arjunrajasekaran201/Chloro-Gauge/CAD DESIGNS/ELECTRONICS/texture613057584_826298173_16777215.png

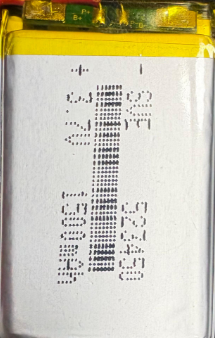
CAD DESIGNS/ELECTRONICS/texture613057584_826298173_16777215.png
