arjunrajasekaran201/Chloro-Gauge/IMAGES/20251020_181038912_iOS.jpg

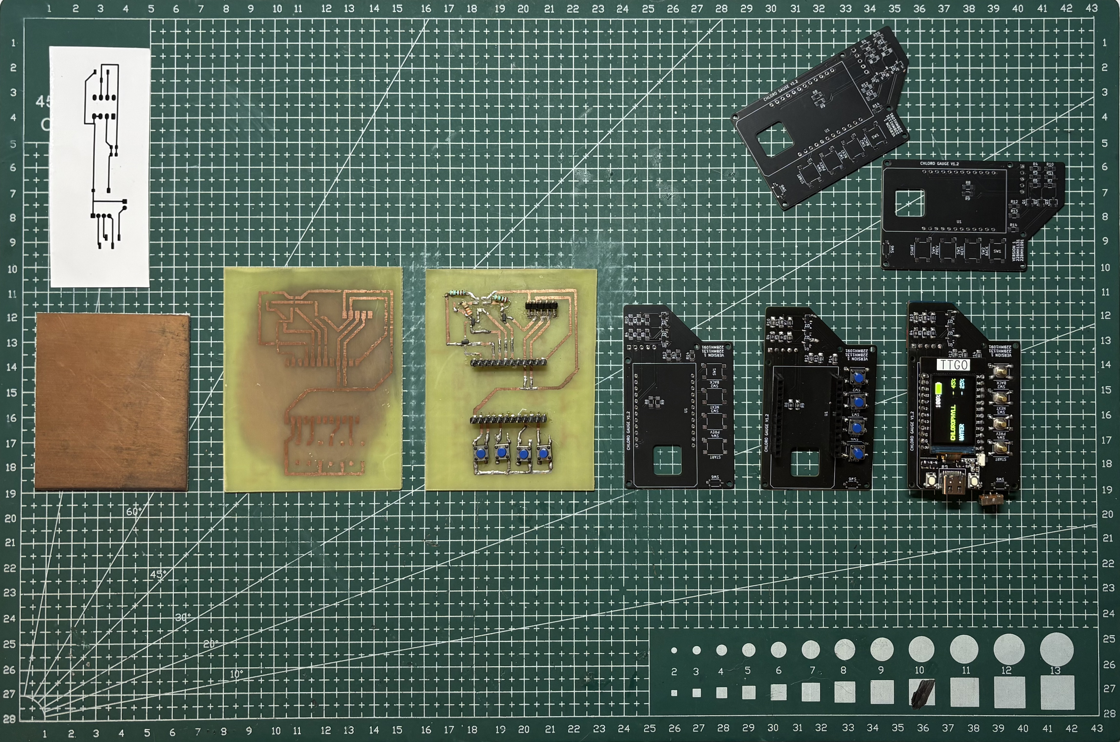
IMAGES/20251020_181038912_iOS.jpg
