arjunrajasekaran201/Chloro-Gauge/REFERENCE/Links.txt

EPS32 Sparkfun - https://docs.sparkfun.com/SparkFun_Thing_Plus_ESP32_C6/print_view/?utm_source=chatgpt.com
