arjunrajasekaran201/Chloro-Gauge/IMAGES/20251020_180931866_iOS.jpg

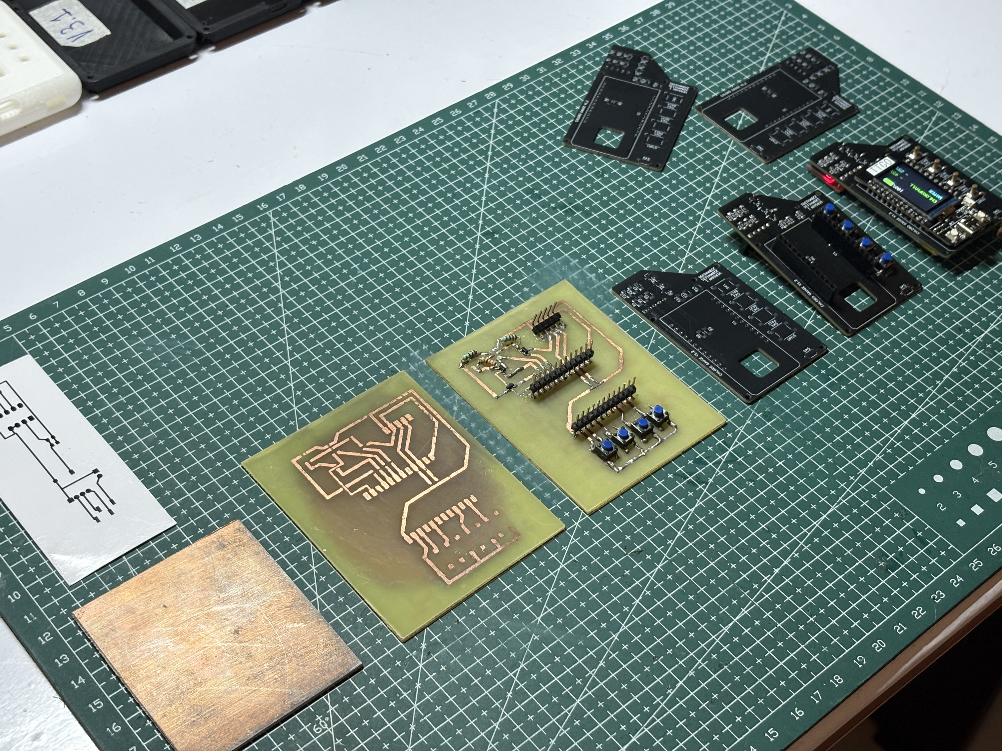
IMAGES/20251020_180931866_iOS.jpg
