arjunrajasekaran201/Chloro-Gauge/IMAGES/20251020_181259716_iOS.jpg

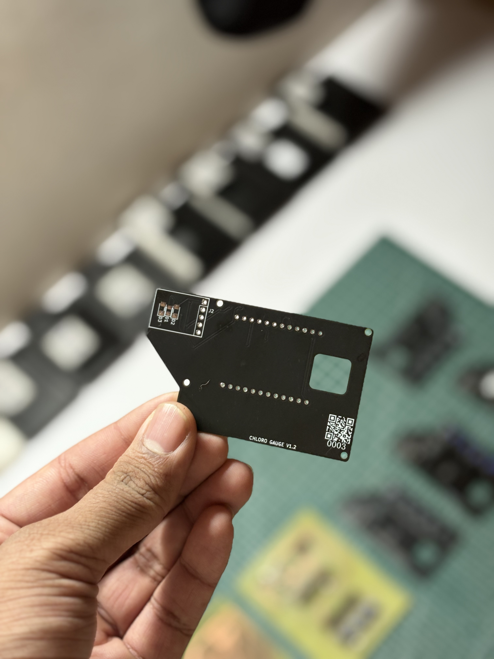
IMAGES/20251020_181259716_iOS.jpg
