arjunrajasekaran201/Chloro-Gauge/IMAGES/20251020_181925314_iOS.jpg

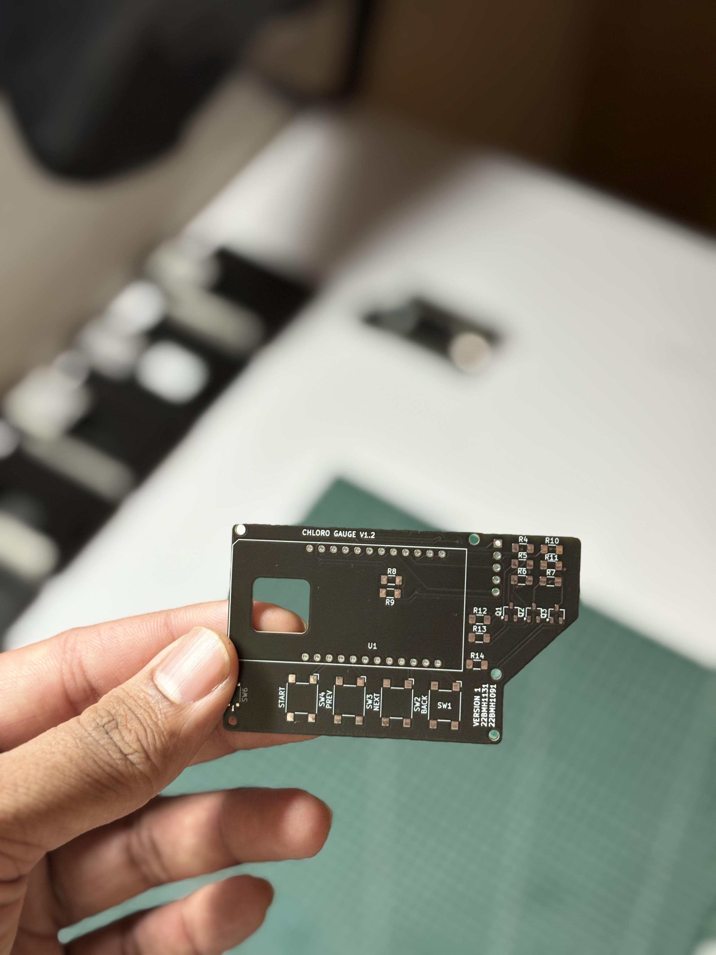
IMAGES/20251020_181925314_iOS.jpg
