arjunrajasekaran201/Chloro-Gauge/IMAGES/20251020_182045030_iOS.jpg

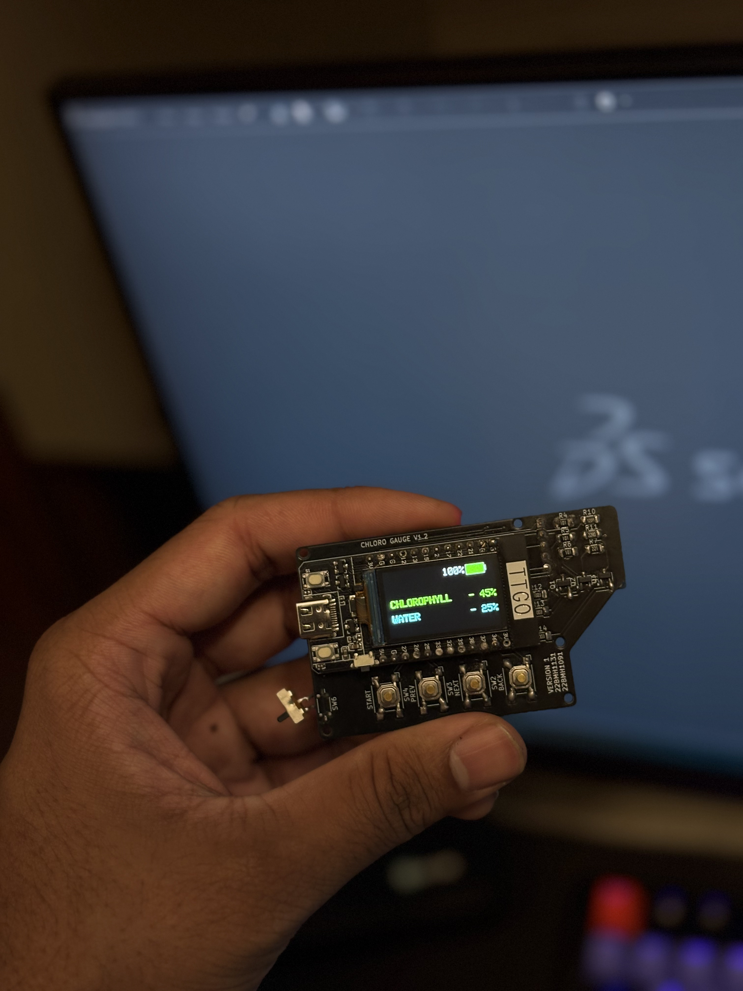
IMAGES/20251020_182045030_iOS.jpg
