arjunrajasekaran201/Chloro-Gauge/IMAGES/20251024_093119306_iOS.jpg

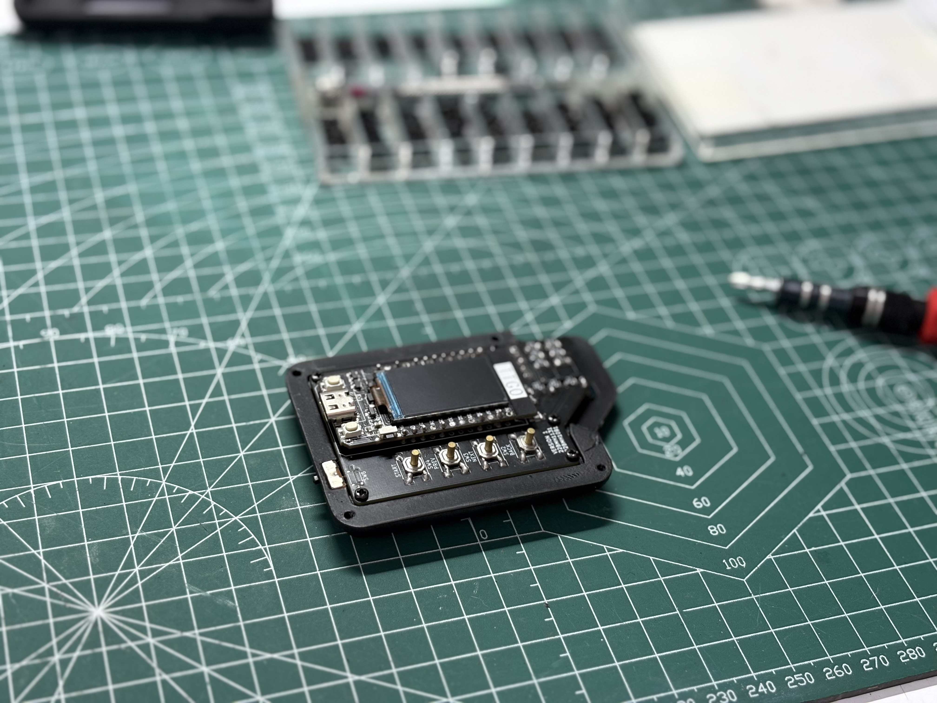
IMAGES/20251024_093119306_iOS.jpg
