arjunrajasekaran201/Chloro-Gauge/IMAGES/20251024_094013495_iOS.jpg

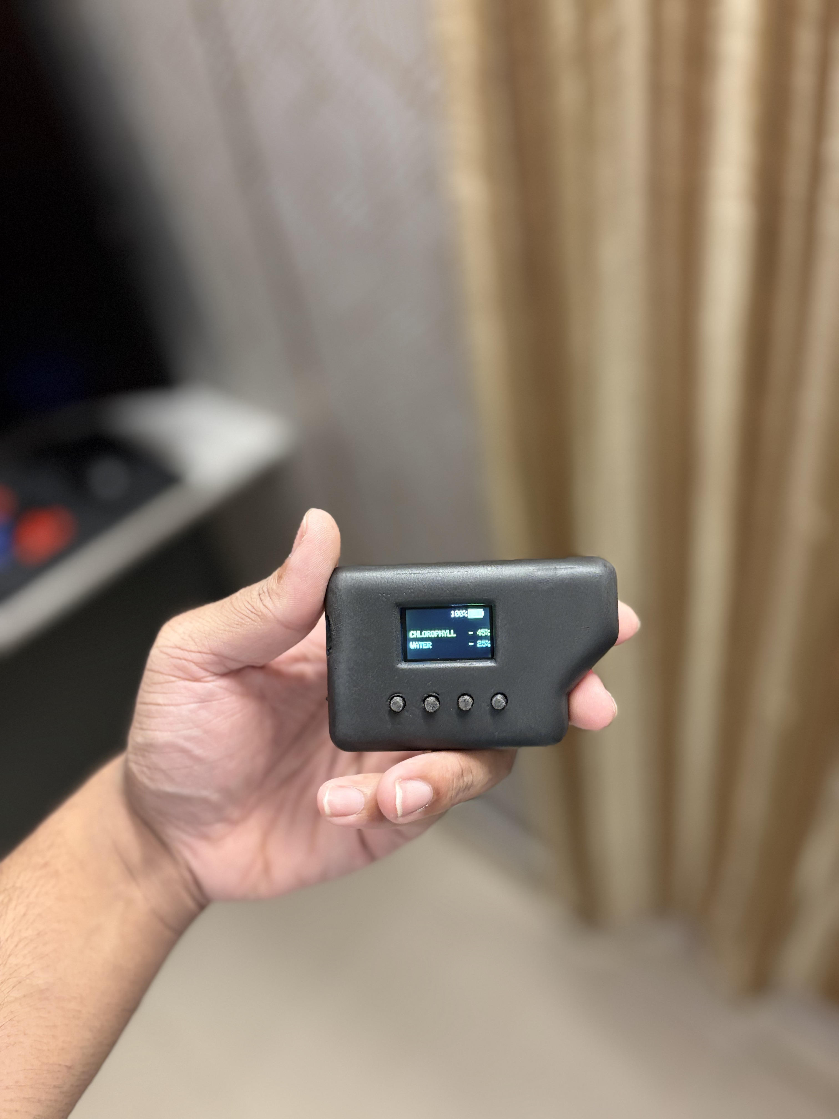
IMAGES/20251024_094013495_iOS.jpg
