arjunrajasekaran201/Chloro-Gauge/IMAGES/20251024_094024455_iOS.jpg

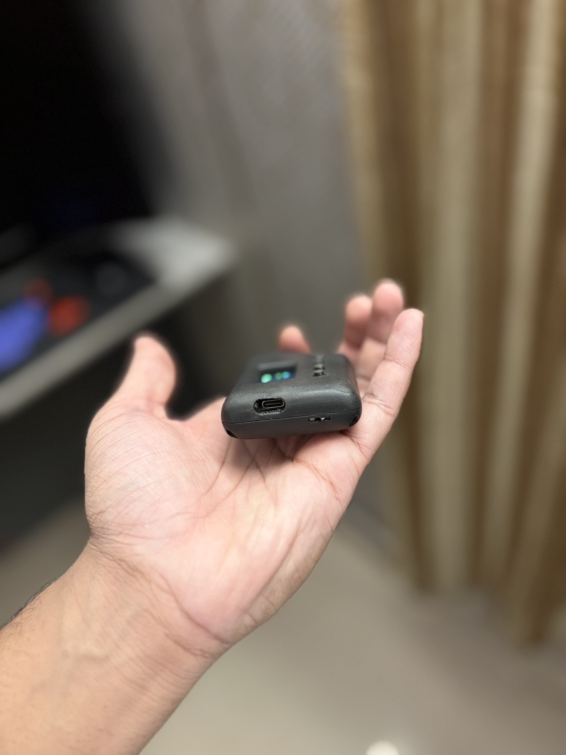
IMAGES/20251024_094024455_iOS.jpg
