arjunrajasekaran201/Chloro-Gauge/IMAGES/20251024_094029636_iOS.jpg

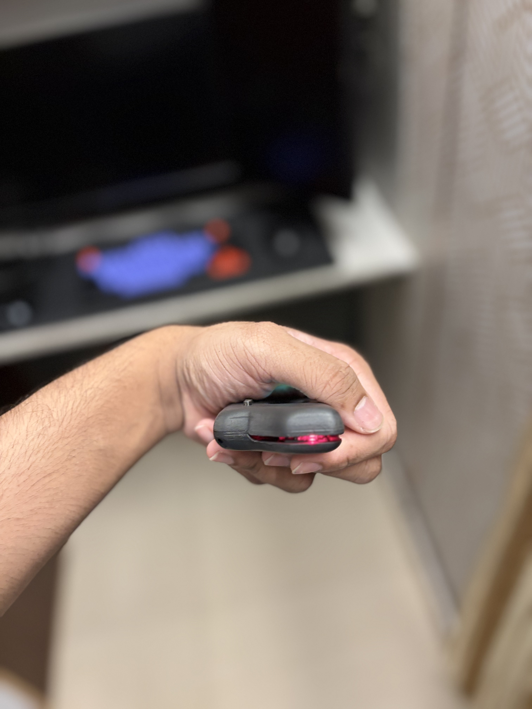
IMAGES/20251024_094029636_iOS.jpg
