arjunrajasekaran201/Chloro-Gauge/IMAGES/20251024_095227139_iOS.jpg

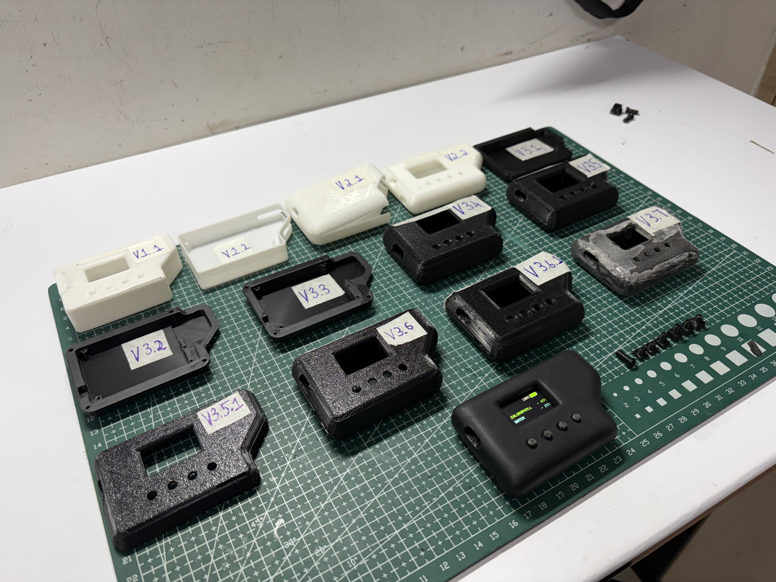
IMAGES/20251024_095227139_iOS.jpg
