arjunrajasekaran201/Chloro-Gauge/IMAGES/20251024_095240331_iOS.jpg

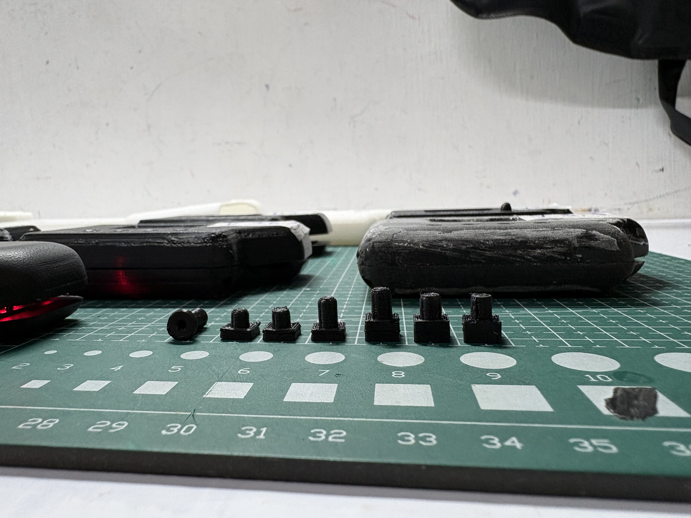
IMAGES/20251024_095240331_iOS.jpg
