arjunrajasekaran201/Chloro-Gauge/IMAGES/20251024_095247498_iOS.jpg

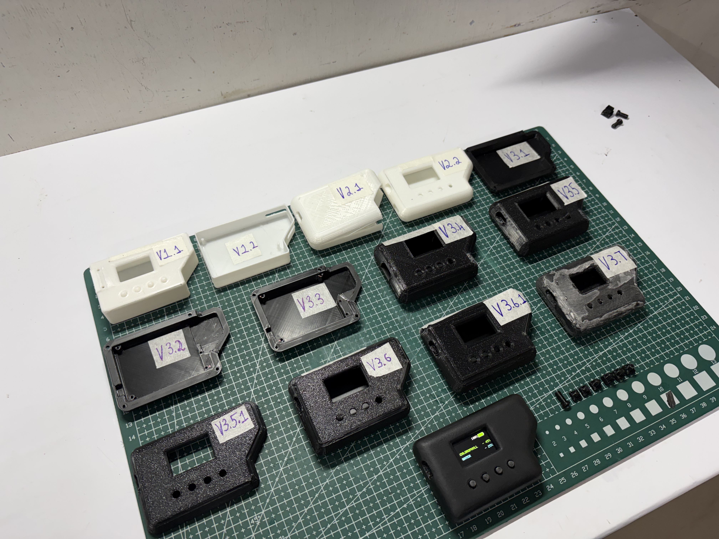
IMAGES/20251024_095247498_iOS.jpg
