arjunrajasekaran201/Chloro-Gauge/IMAGES/20251024_123838072_iOS.jpg

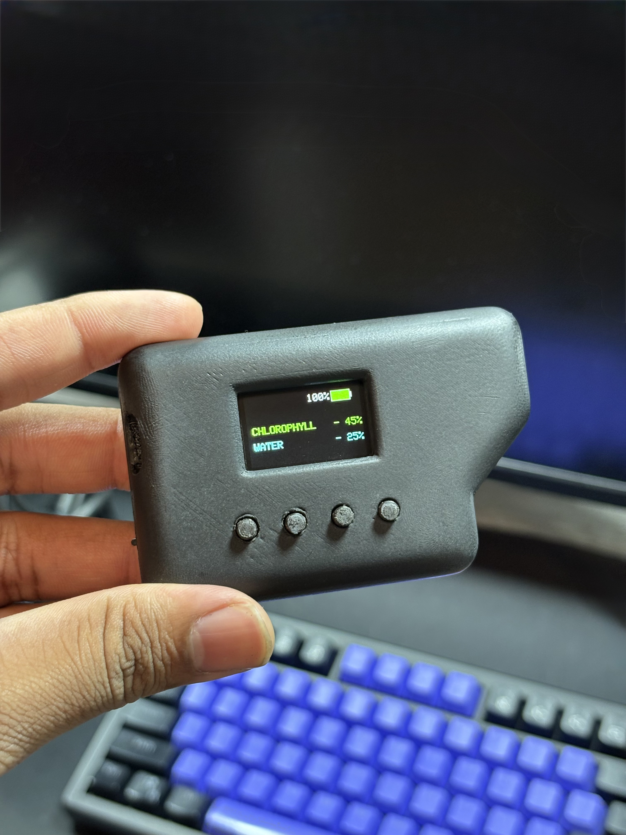
IMAGES/20251024_123838072_iOS.jpg
