arjunrajasekaran201/Chloro-Gauge/IMAGES/file_2025-10-27_20.23.28.png

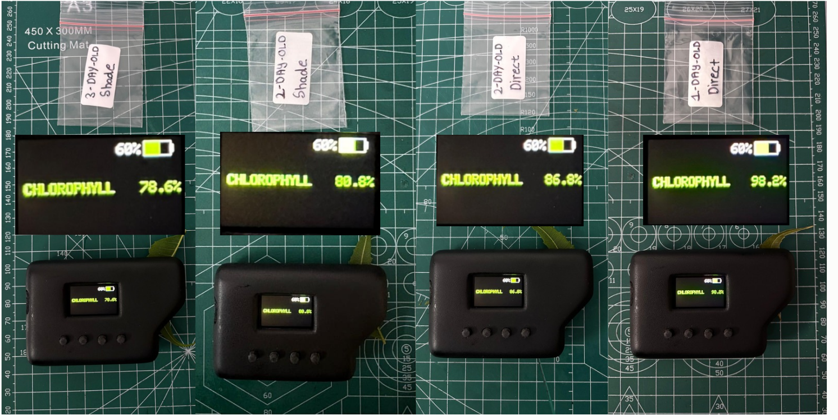
IMAGES/file_2025-10-27_20.23.28.png
