arjunrajasekaran201/Chloro-Gauge/IMAGES/Screenshot 2025-10-21 000112.png

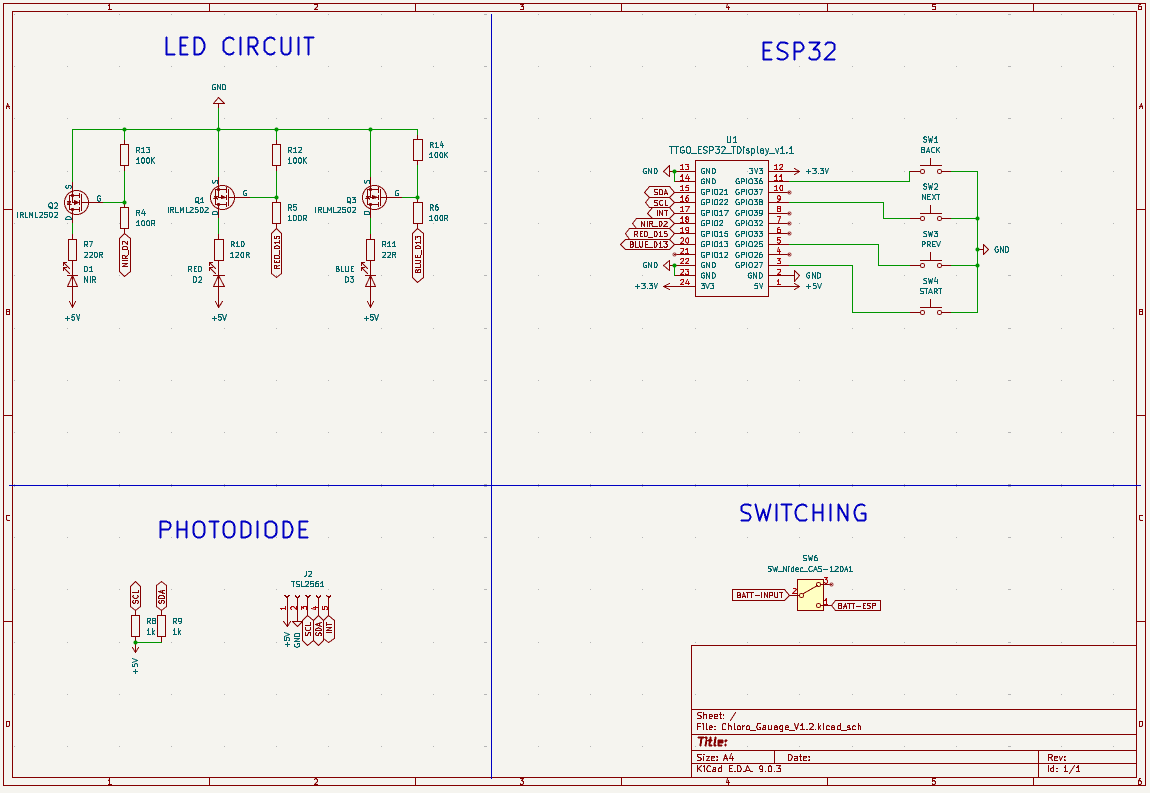
IMAGES/Screenshot 2025-10-21 000112.png
