arjunrajasekaran201/Chloro-Gauge/IMAGES/Screenshot 2025-10-21 000212.png

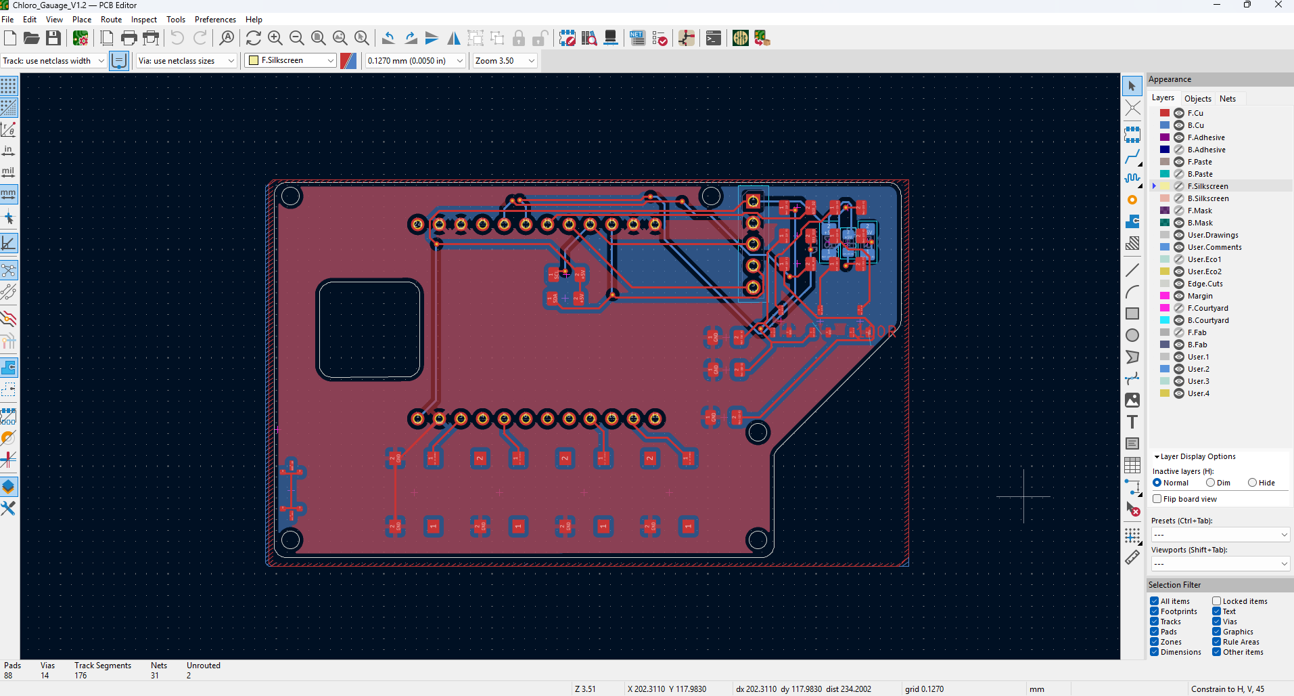
IMAGES/Screenshot 2025-10-21 000212.png
