arjunrajasekaran201/Chloro-Gauge/IMAGES/Screenshot 2025-10-24 180306.png

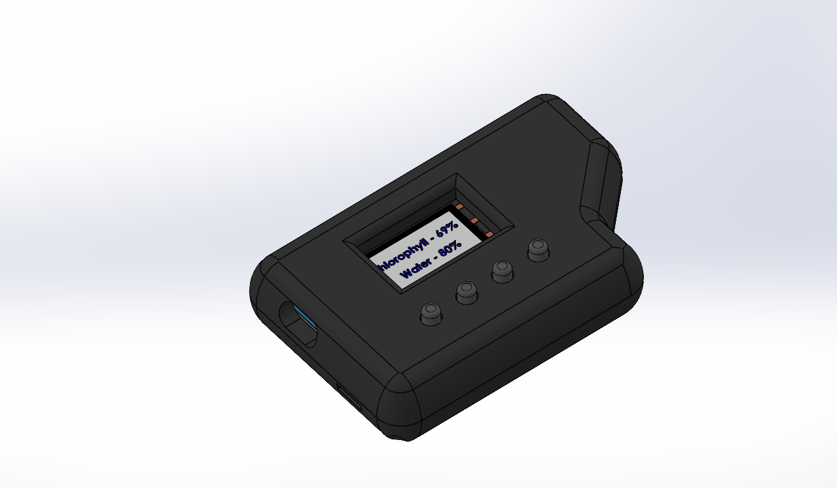
IMAGES/Screenshot 2025-10-24 180306.png
