arjunrajasekaran201/Chloro-Gauge/IMAGES/Screenshot 2025-10-29 220108.png

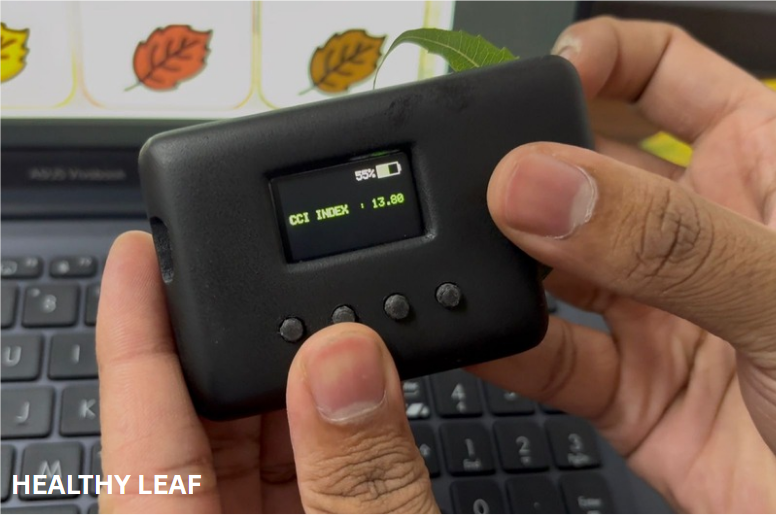
IMAGES/Screenshot 2025-10-29 220108.png
