arjunrajasekaran201/Chloro-Gauge/IMAGES/WhatsApp Image 2025-10-28 at 01.46.50_9ecb65c4.jpg

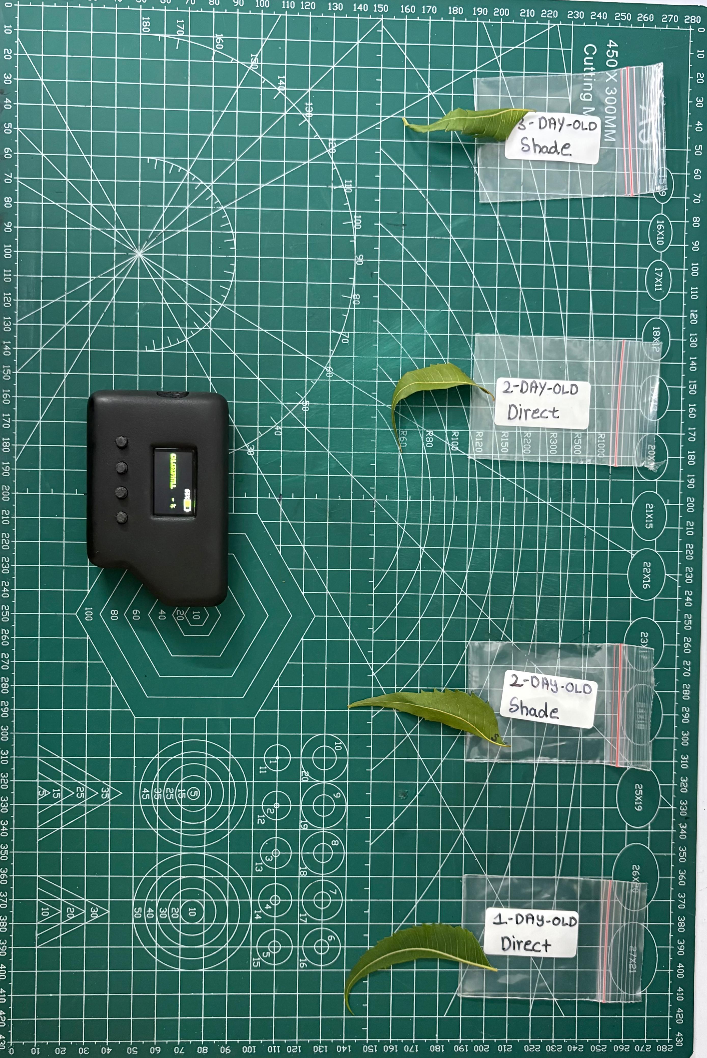
IMAGES/WhatsApp Image 2025-10-28 at 01.46.50_9ecb65c4.jpg
