arjunrajasekaran201/Chloro-Gauge/CAD DESIGNS/KI CAD IMPORTS/TTGO1.SLDASM

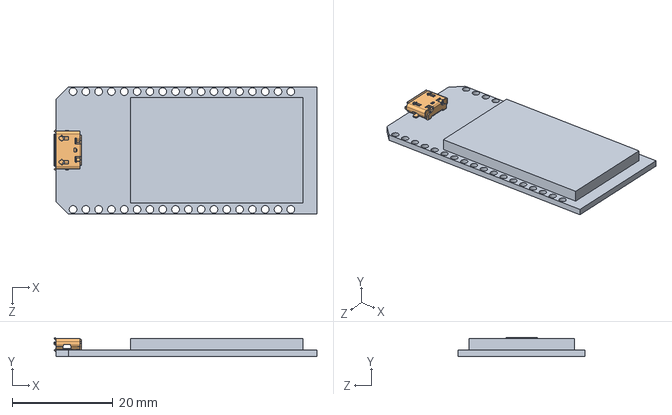
[picture p24: CAD file, 2025-10-29]
CAD DESIGNS/KI CAD IMPORTS/TTGO1.SLDASM
52.1 x 3.77 x 25.1 mm
TTGO-ESP32LORA
microusb
