arjunrajasekaran201/Chloro-Gauge/CAD DESIGNS/CASE DESIGNS/Top Cap V1.SLDPRT

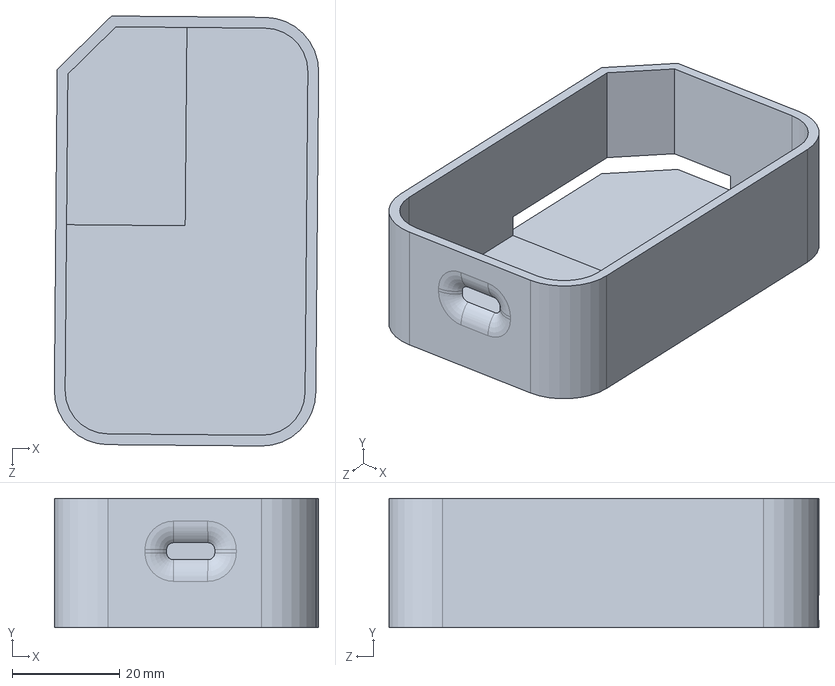
[picture p25: CAD file, 2025-10-29]
CAD DESIGNS/CASE DESIGNS/Top Cap V1.SLDPRT
49.0 x 24.0 x 79.7 mm
