arjunrajasekaran201/Chloro-Gauge/CAD DESIGNS/ELECTRONICS/switch.SLDPRT

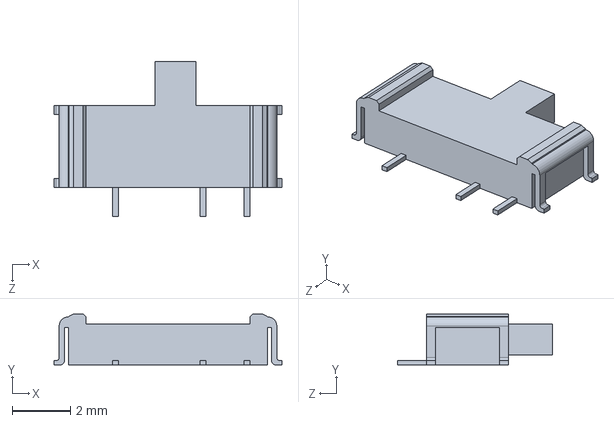
[picture p26: CAD file, 2025-10-29]
CAD DESIGNS/ELECTRONICS/switch.SLDPRT
7.80 x 1.74 x 5.31 mm
