arjunrajasekaran201/Chloro-Gauge/CAD DESIGNS/FINAL DESIGN/Chloro Gauge Top.SLDPRT

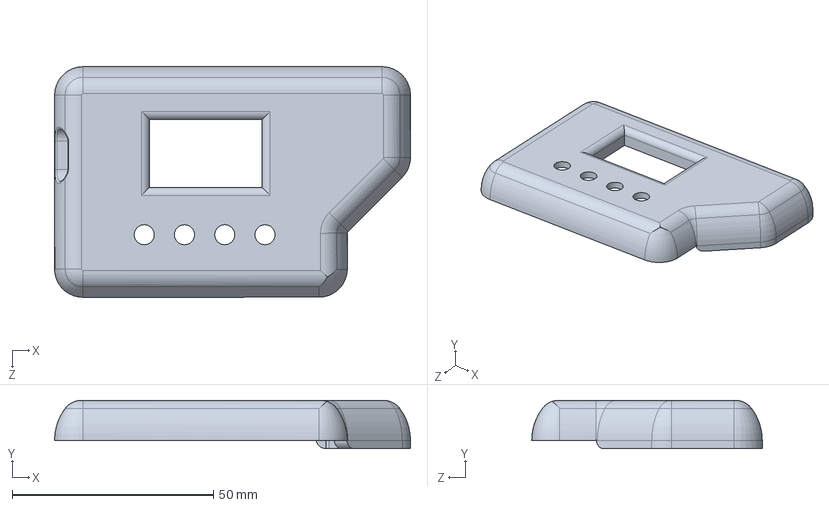
[picture p27: CAD file, 2025-10-29]
CAD DESIGNS/FINAL DESIGN/Chloro Gauge Top.SLDPRT
88.4 x 12.0 x 57.3 mm
