arjunrajasekaran201/Chloro-Gauge/CAD DESIGNS/CASE DESIGNS/Casing_Lower.SLDPRT

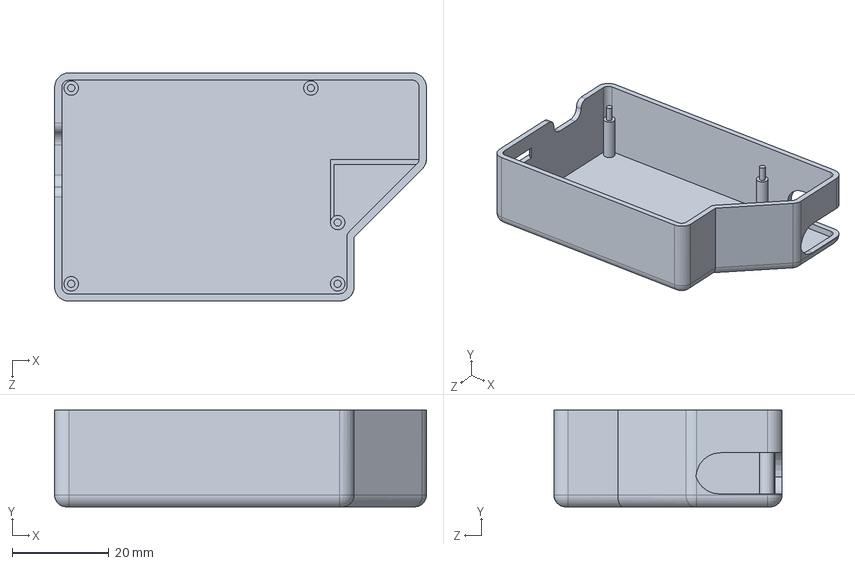
[picture p28: CAD file, 2025-10-29]
CAD DESIGNS/CASE DESIGNS/Casing_Lower.SLDPRT
76.8 x 20.0 x 47.1 mm
