arjunrajasekaran201/Chloro-Gauge/CAD DESIGNS/ELECTRONICS/tsl2561.SLDPRT

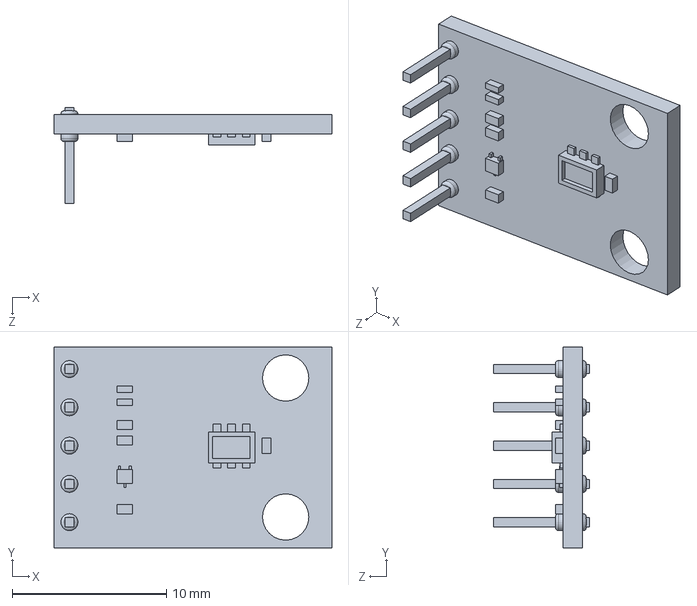
[picture p29: CAD file, 2025-10-29]
CAD DESIGNS/ELECTRONICS/tsl2561.SLDPRT
18.0 x 13.0 x 6.20 mm
