arjunrajasekaran201/Chloro-Gauge/CAD DESIGNS/FINAL DESIGN/Chloro Gauge Bottom.SLDPRT

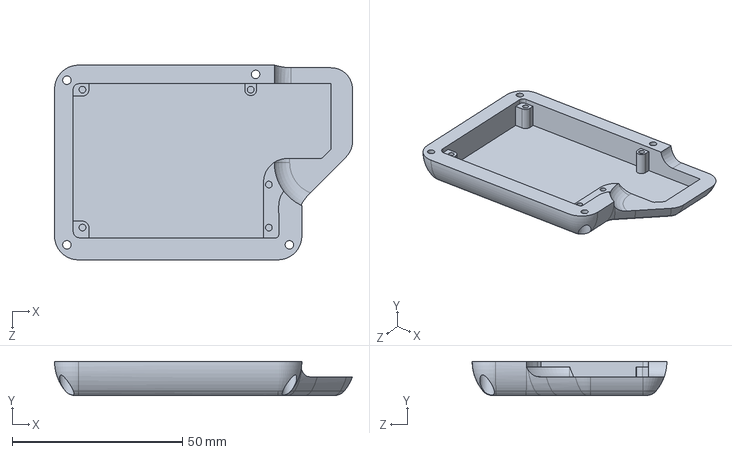
[picture p30: CAD file, 2025-10-29]
CAD DESIGNS/FINAL DESIGN/Chloro Gauge Bottom.SLDPRT
87.6 x 10.0 x 57.3 mm
