arjunrajasekaran201/Chloro-Gauge/CAD DESIGNS/KI CAD IMPORTS/TTGO-ESP32LORA.SLDPRT

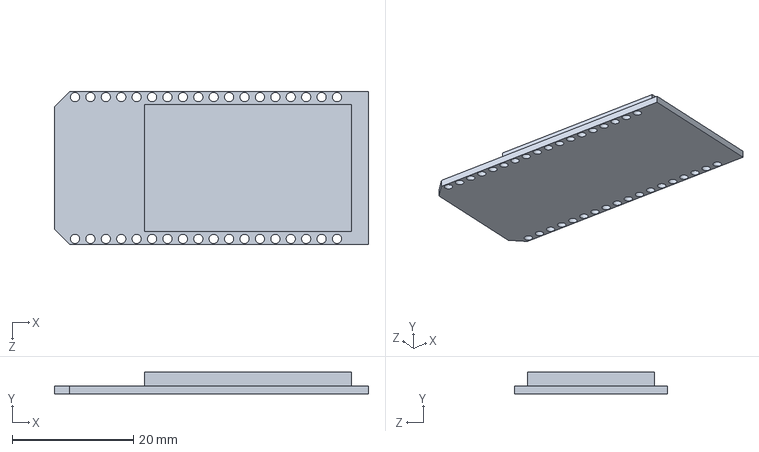
[picture p31: CAD file, 2025-10-29]
CAD DESIGNS/KI CAD IMPORTS/TTGO-ESP32LORA.SLDPRT
51.8 x 3.55 x 25.1 mm
