arjunrajasekaran201/Chloro-Gauge/CAD DESIGNS/CASE DESIGNS/Top lid.SLDPRT

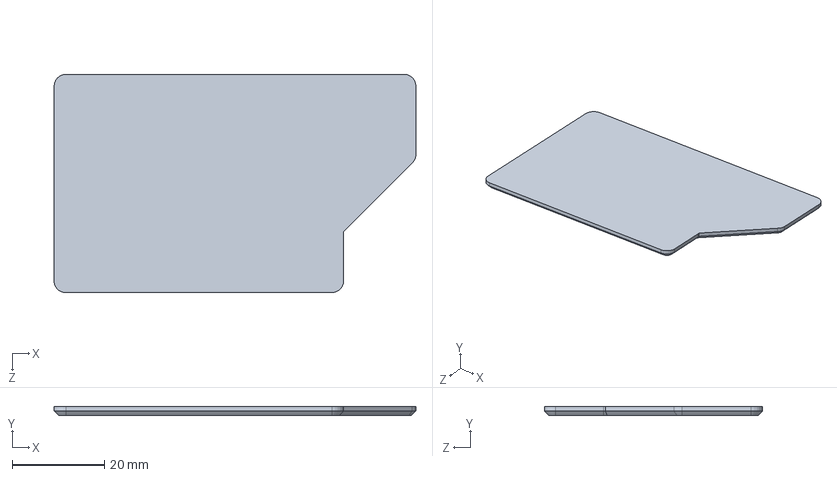
[picture p32: CAD file, 2025-10-29]
CAD DESIGNS/CASE DESIGNS/Top lid.SLDPRT
78.5 x 2.00 x 47.3 mm
