arjunrajasekaran201/Chloro-Gauge/CAD DESIGNS/FINAL DESIGN/button.SLDPRT

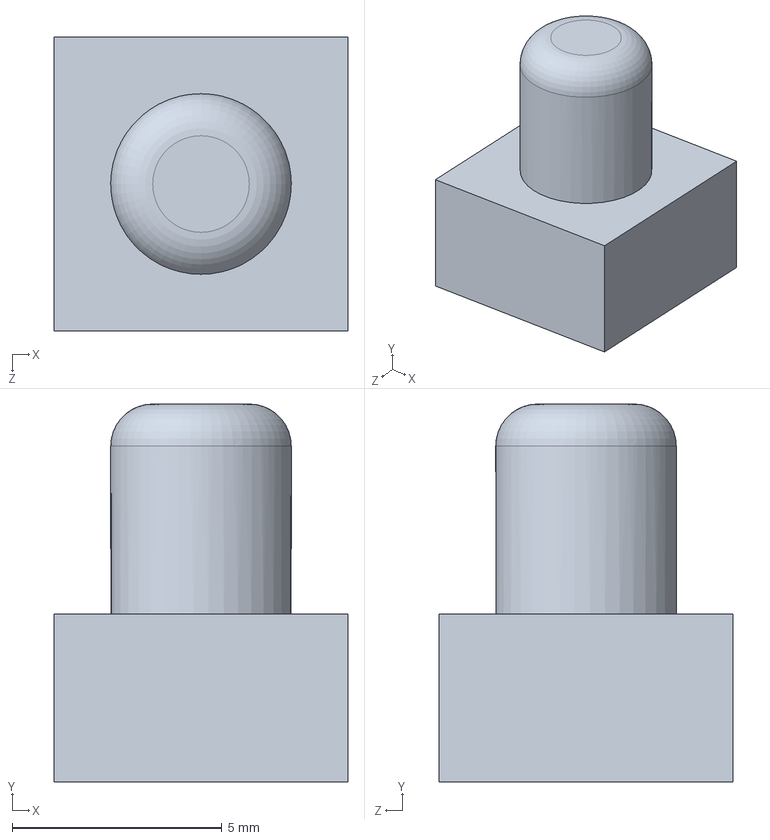
[picture p33: CAD file, 2025-10-29]
CAD DESIGNS/FINAL DESIGN/button.SLDPRT
7.00 x 9.00 x 7.00 mm
