arjunrajasekaran201/Chloro-Gauge/CAD DESIGNS/KI CAD IMPORTS/microusb.SLDPRT

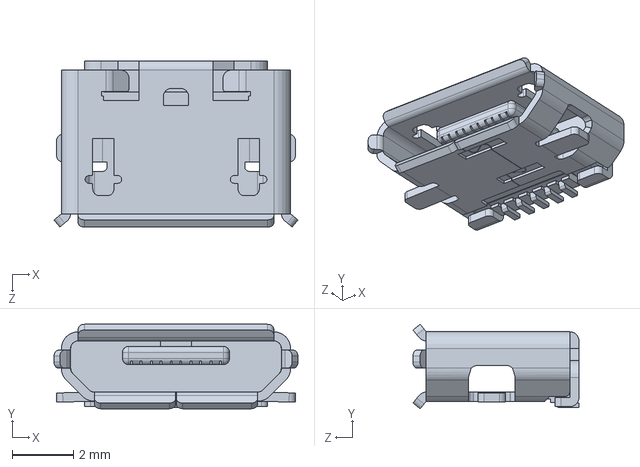
[picture p34: CAD file, 2025-10-29]
CAD DESIGNS/KI CAD IMPORTS/microusb.SLDPRT
7.98 x 2.76 x 5.43 mm
