arjunrajasekaran201/Chloro-Gauge/CAD DESIGNS/CASE DESIGNS/Case lower v2.SLDPRT

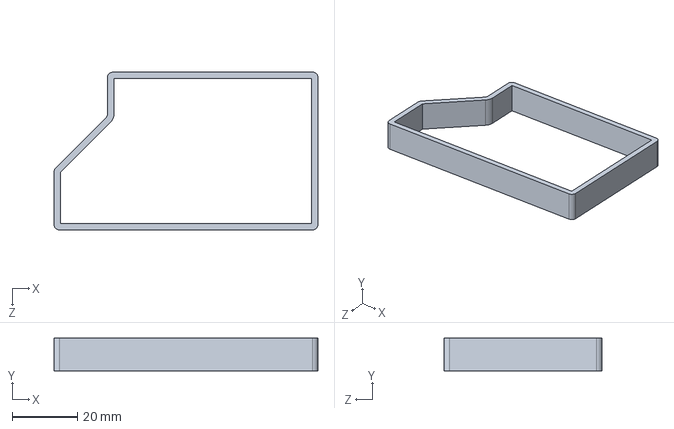
[picture p35: CAD file, 2025-10-29]
CAD DESIGNS/CASE DESIGNS/Case lower v2.SLDPRT
81.2 x 10.0 x 48.5 mm
