arjunrajasekaran201/Chloro-Gauge/CAD DESIGNS/ELECTRONICS/Selector Switch - SS12D00.SLDPRT

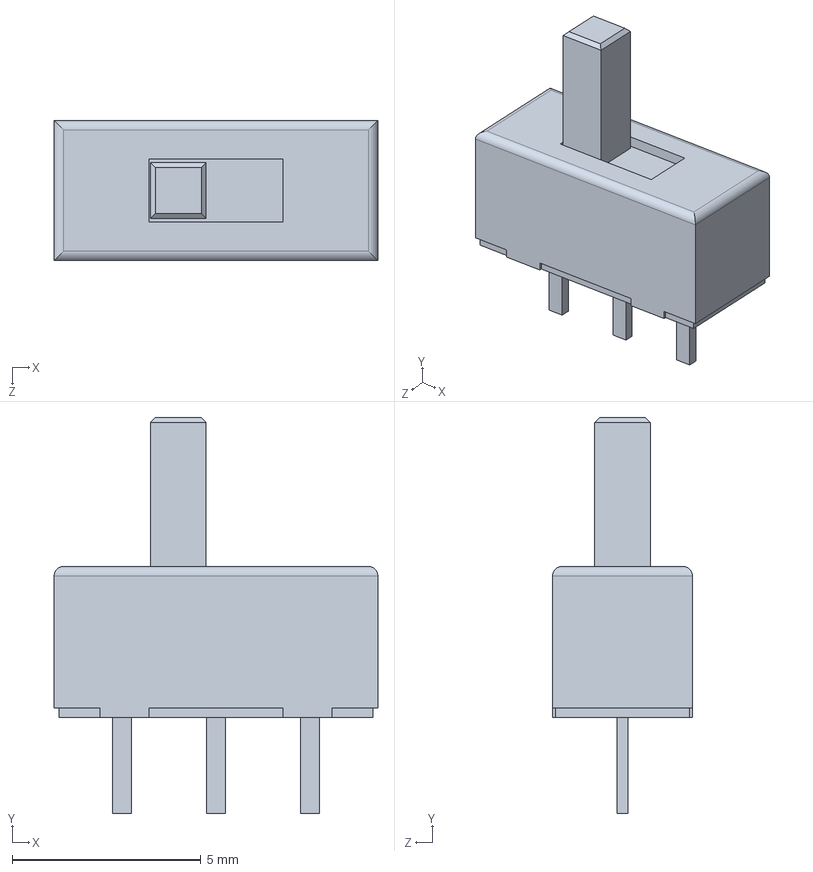
[picture p36: CAD file, 2025-10-29]
CAD DESIGNS/ELECTRONICS/Selector Switch - SS12D00.SLDPRT
8.59 x 10.5 x 3.71 mm
