arjunrajasekaran201/Chloro-Gauge/CAD DESIGNS/CASE DESIGNS/Case Test.SLDPRT

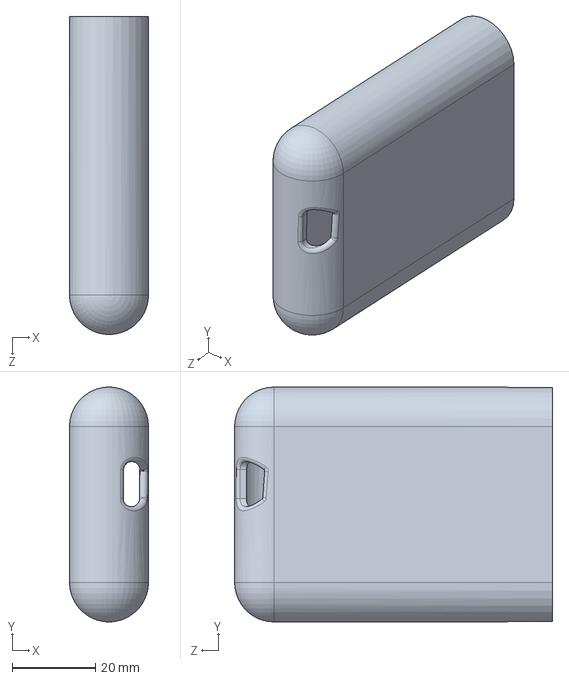
[picture p37: CAD file, 2025-10-29]
CAD DESIGNS/CASE DESIGNS/Case Test.SLDPRT
19.0 x 56.5 x 76.5 mm
