arjunrajasekaran201/Chloro-Gauge/CAD DESIGNS/ELECTRONICS/OLED_0.91_128x32.SLDPRT

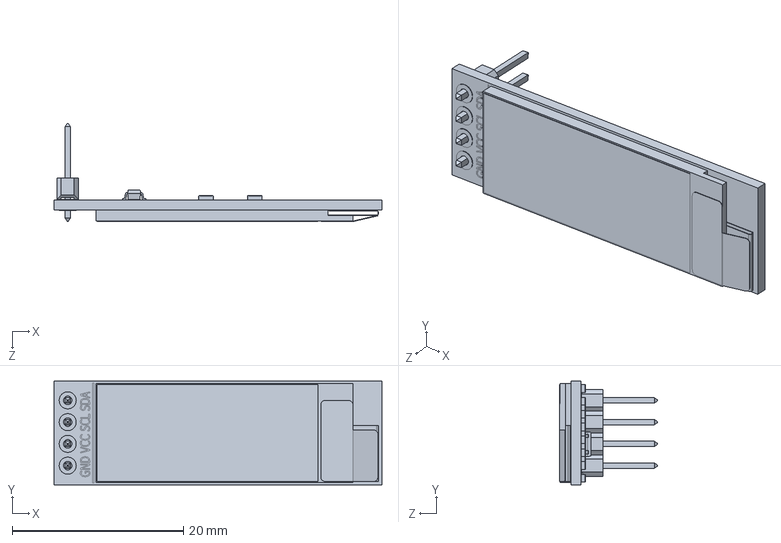
[picture p38: CAD file, 2025-10-29]
CAD DESIGNS/ELECTRONICS/OLED_0.91_128x32.SLDPRT
38.3 x 12.1 x 11.5 mm
