arjunrajasekaran201/Chloro-Gauge/CAD DESIGNS/CASE DESIGNS/Button.SLDPRT

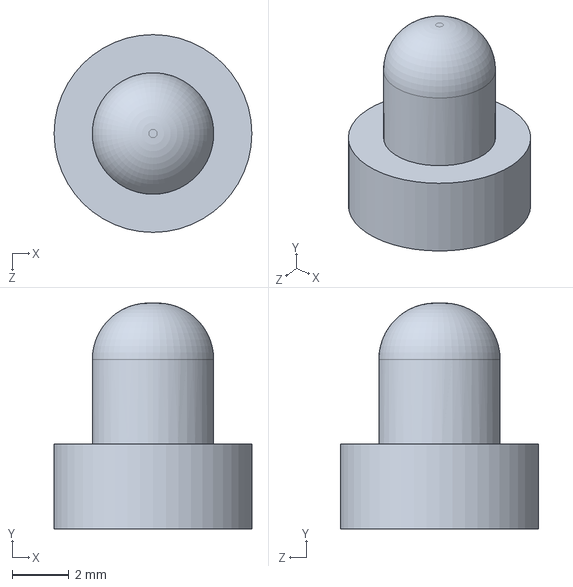
[picture p39: CAD file, 2025-10-29]
CAD DESIGNS/CASE DESIGNS/Button.SLDPRT
7.00 x 8.00 x 7.00 mm
