arjunrajasekaran201/Chloro-Gauge/CAD DESIGNS/ELECTRONICS/DFR0654.SLDPRT

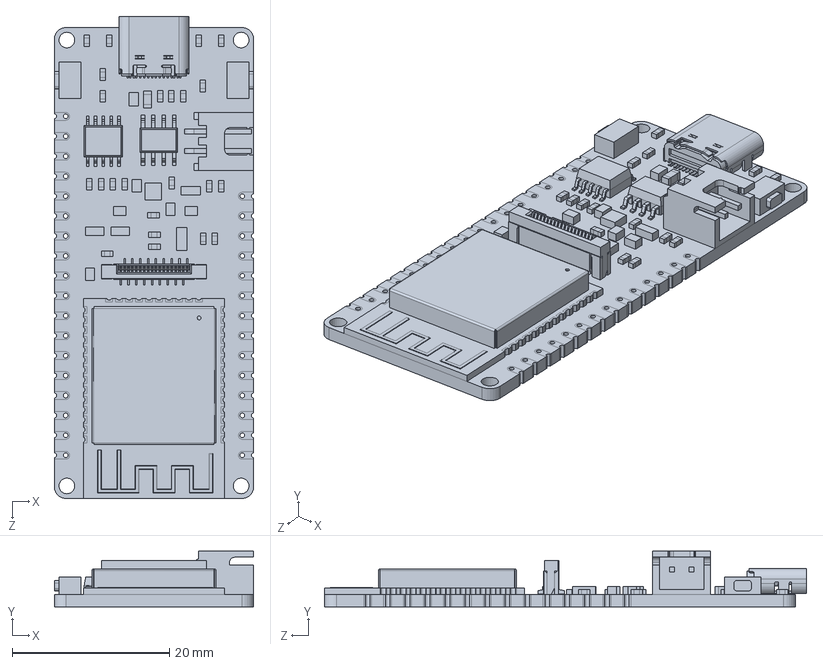
[picture p40: CAD file, 2025-10-29]
CAD DESIGNS/ELECTRONICS/DFR0654.SLDPRT
25.4 x 7.10 x 61.4 mm
