arjunrajasekaran201/Chloro-Gauge/CAD DESIGNS/CASE DESIGNS/mid holder.SLDPRT

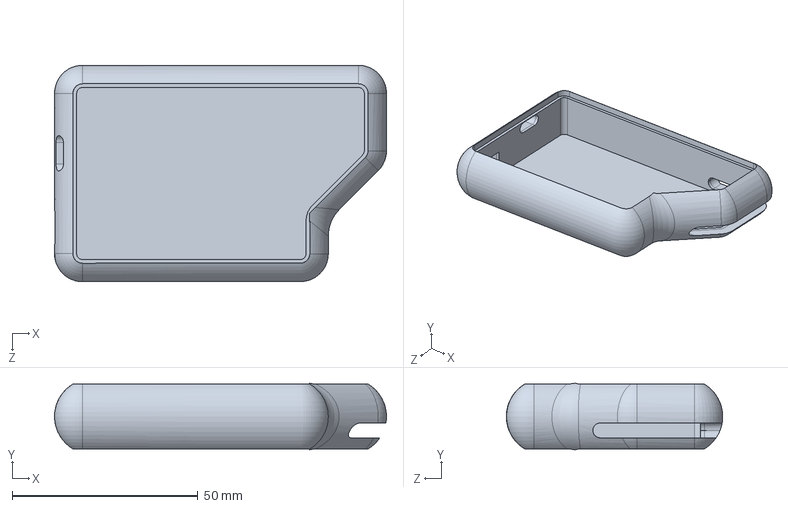
[picture p41: CAD file, 2025-10-29]
CAD DESIGNS/CASE DESIGNS/mid holder.SLDPRT
89.4 x 18.0 x 58.3 mm
