arjunrajasekaran201/Chloro-Gauge/CAD DESIGNS/ELECTRONICS/Assem1.3MF

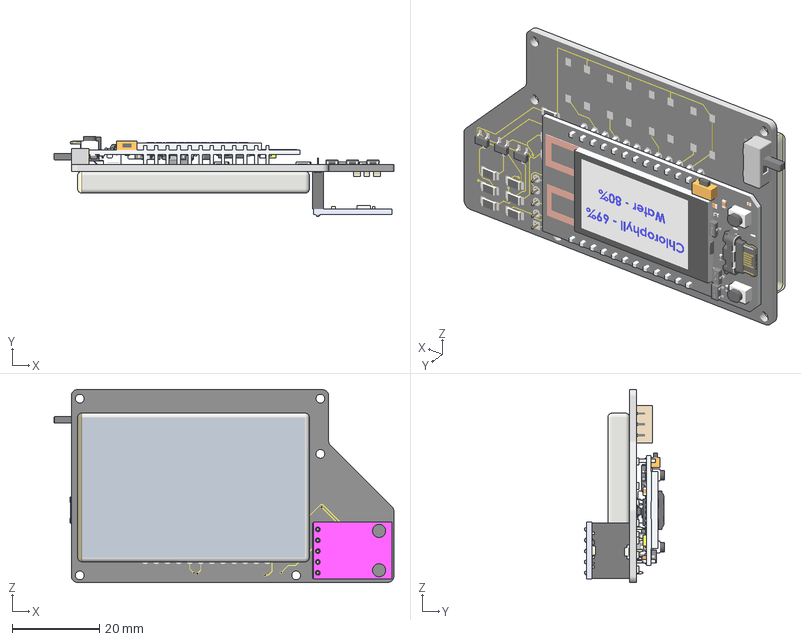
[picture p42: CAD file, 2025-10-29]
CAD DESIGNS/ELECTRONICS/Assem1.3MF
77.7 x 18.2 x 44.1 mm
