arjunrajasekaran201/Chloro-Gauge/CAD DESIGNS/CASE DESIGNS/Casing_Upper.SLDPRT

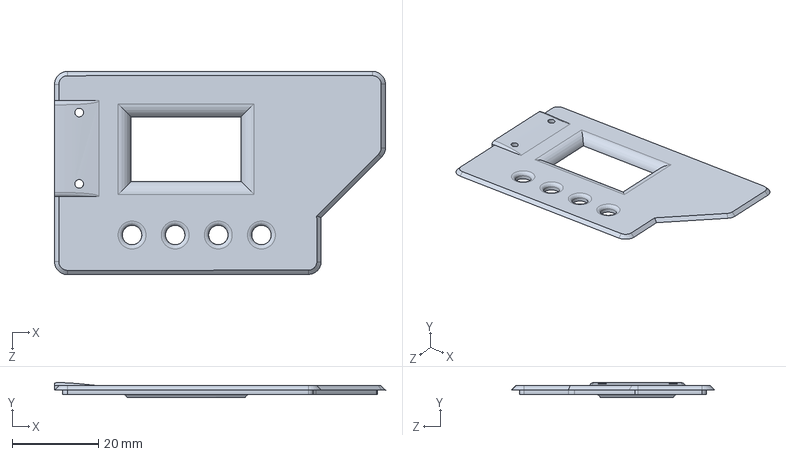
[picture p43: CAD file, 2025-10-29]
CAD DESIGNS/CASE DESIGNS/Casing_Upper.SLDPRT
76.8 x 3.42 x 47.2 mm
