arjunrajasekaran201/Chloro-Gauge/CAD DESIGNS/ELECTRONICS/Battery.SLDPRT

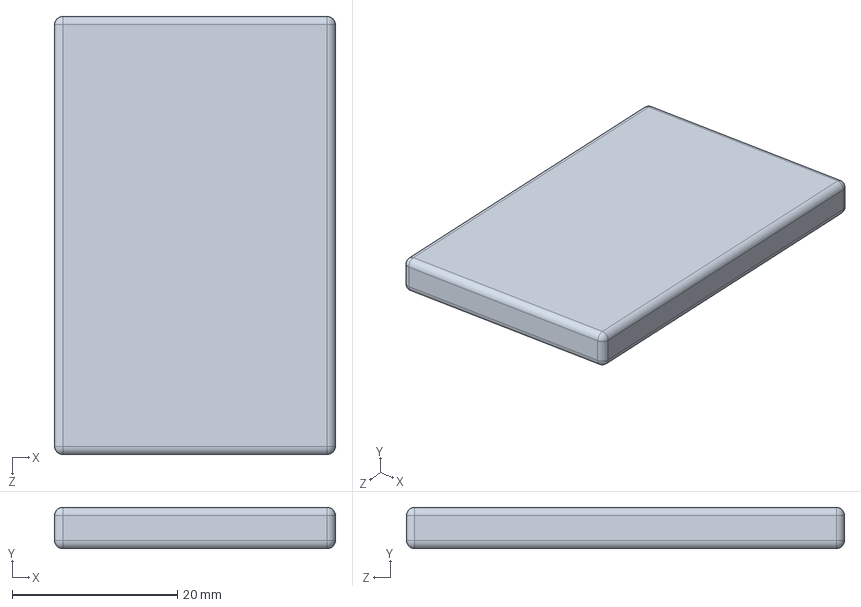
[picture p44: CAD file, 2025-10-29]
CAD DESIGNS/ELECTRONICS/Battery.SLDPRT
34.0 x 5.00 x 53.0 mm
