arjunrajasekaran201/Chloro-Gauge/CAD DESIGNS/ELECTRONICS/1000mAhlipo901860.SLDPRT

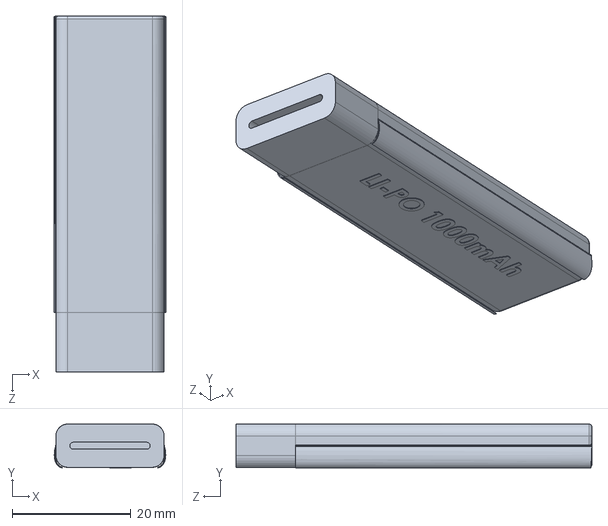
[picture p45: CAD file, 2025-10-29]
CAD DESIGNS/ELECTRONICS/1000mAhlipo901860.SLDPRT
18.8 x 7.41 x 60.0 mm
