arjunrajasekaran201/Chloro-Gauge/CAD DESIGNS/ELECTRONICS/Assembly.SLDASM

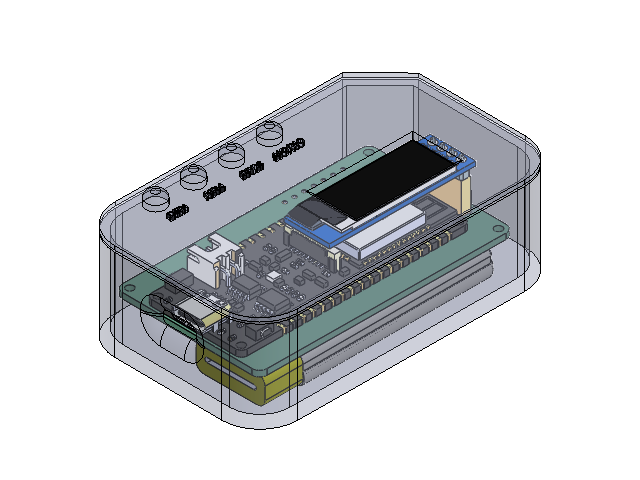
[picture p46: CAD file, 2025-10-29]
CAD DESIGNS/ELECTRONICS/Assembly.SLDASM
1000mAhlipo901860
OLED_0.91_128x32
TCS34725 RGB sensor
Chloro_Gauge_V1.1
Top Cap V1
Cover
