arjunrajasekaran201/Chloro-Gauge/(list of files, cad)

Other CAD files:
CAD DESIGNS/ELECTRONICS/TCS34725 RGB sensor.SLDPRT
CAD DESIGNS/FINAL DESIGN/Chloro Gauge Bottom.STL
CAD DESIGNS/FINAL DESIGN/Chloro Gauge Top.STL
CAD DESIGNS/FINAL DESIGN/button.STL
