arjunrajasekaran201/Chloro-Gauge/PCB/Chloro_Gauge_V1.1/Chloro_Gauge_V1.1-F_Cu.pdf

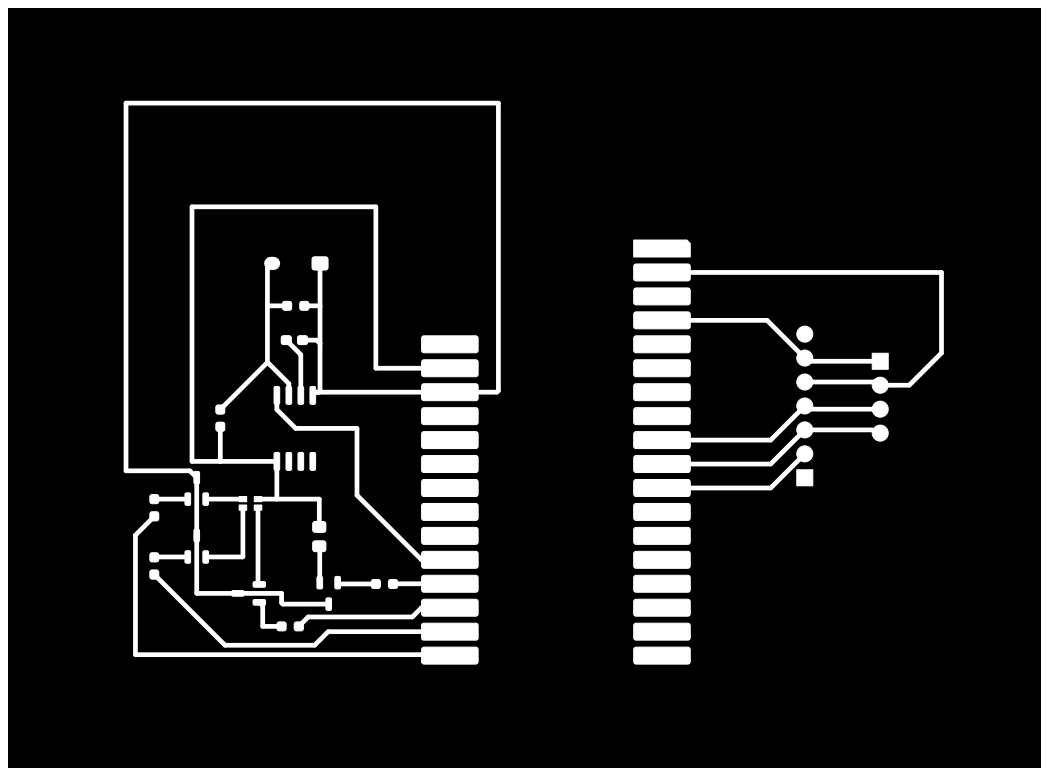
[picture p47: page 1]
