arjunrajasekaran201/Chloro-Gauge/PCB/Chloro_Gauge_V1.1/Chloro_Gauge_V1.1.kicad_pcb

## KiCad design PCB/Chloro_Gauge_V1.1/Chloro_Gauge_V1.1.kicad_pcb (2025-10-29)

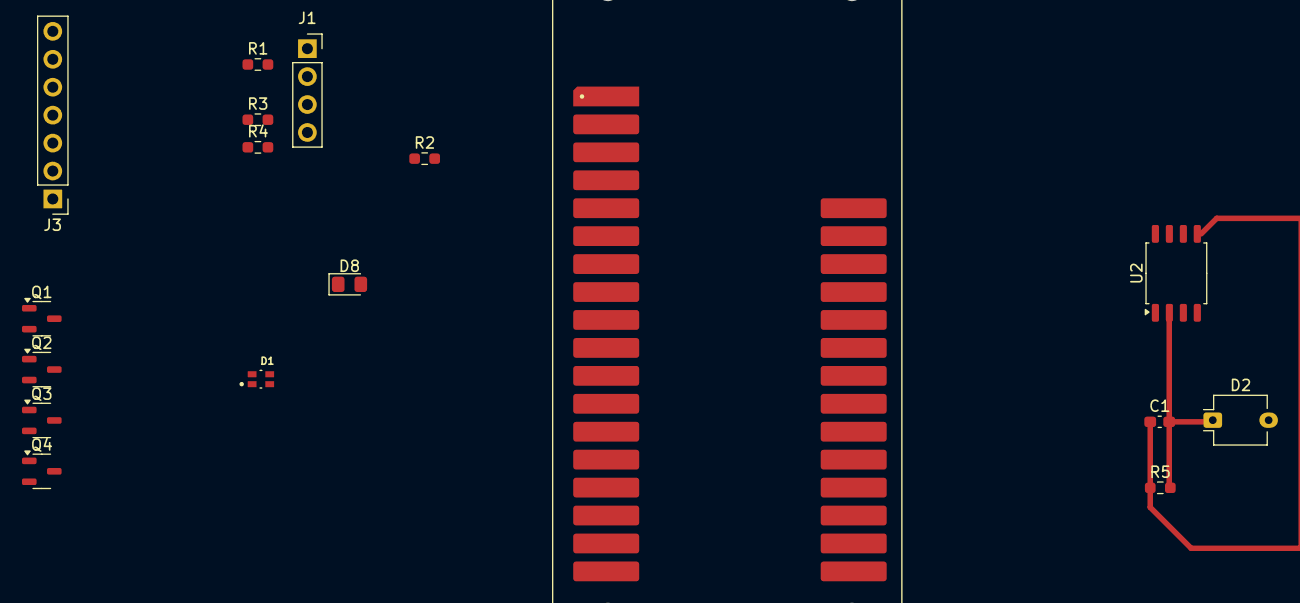
[picture p48: board Chloro_Gauge_V1.1.kicad_pcb from above]

Board: 2 copper layers, 17 parts (0 on the bottom side), 19 nets.

Parts:
C1: 100nF; C_0603_1608Metric_Pad1.08x0.95mm_HandSolder
D1: Everlight_RGB_19-237_R6GHBHC-A01_2T; LED_19-237_R6GHBHC-A01_2T
D2: BPW34; Osram_DIL2_4.3x4.65mm_P5.08mm
D8: NIR; LED_0805_2012Metric_Pad1.15x1.40mm_HandSolder
J1: DISPLAY; PinSocket_1x04_P2.54mm_Vertical
J3: COLOUR SENSOR; PinHeader_1x07_P2.54mm_Vertical
Q1, Q2, Q3, Q4: BC547; SOT-23-3
R1, R2, R3, R4: 1k; R_0603_1608Metric_Pad0.98x0.95mm_HandSolder
R5: 10k; R_0603_1608Metric_Pad0.98x0.95mm_HandSolder
U1: DFR0654; MODULE_DFR0654
U2: UA741CN; SOIC-8_5.3x5.3mm_P1.27mm

Connections:
+3.3V: D1.4, D8.2 (A), J1.2, J3.5, U1.2 (3.3V), U1.31 (3.3V), U2.3 (V+)
BLUE_D10: R3.1, U1.21 (D12)
CLRSNS_INT_D9: J3.2, U1.11 (D9)
GND: D2.2 (A), J1.1, J3.6, Q1.3 (E), Q2.3 (E), Q3.3 (E), Q4.3 (E), U1.4 (GND), U1.30 (GND), U2.1 (+), U2.4 (V-)
GREEN_D11: R2.1, U1.20 (D11)
NIR_D13: R4.2, U1.22 (D13)
unnamed: C1.2, D2.1 (K), R5.2, U2.2 (-)
unnamed: D8.1 (K), Q4.1 (C)
unnamed: Q1.2 (B), R1.2
unnamed: D1.1, Q1.1 (C)
unnamed: Q2.2 (B), R2.2
unnamed: D1.2, Q2.1 (C)
unnamed: Q3.2 (B), R3.2
unnamed: D1.3, Q3.1 (C)
unnamed: Q4.2 (B), R4.1
PHOTODIODE_ADC_A0: C1.1, R5.1, U1.23 (A0), U2.5
RED_D12: R1.1, U1.19 (D10)
SCL: J1.3, J3.4, U1.9 (SCL), U1.29 (SCL)
SDA: J1.4, J3.3, U1.10 (SDA), U1.28 (SDA)
