arjunrajasekaran201/Chloro-Gauge/PCB/Chloro_Gauage_V1.2/Chloro_Gauage_V1.2.kicad_pcb

## KiCad design PCB/Chloro_Gauage_V1.2/Chloro_Gauage_V1.2.kicad_pcb (2025-10-29)

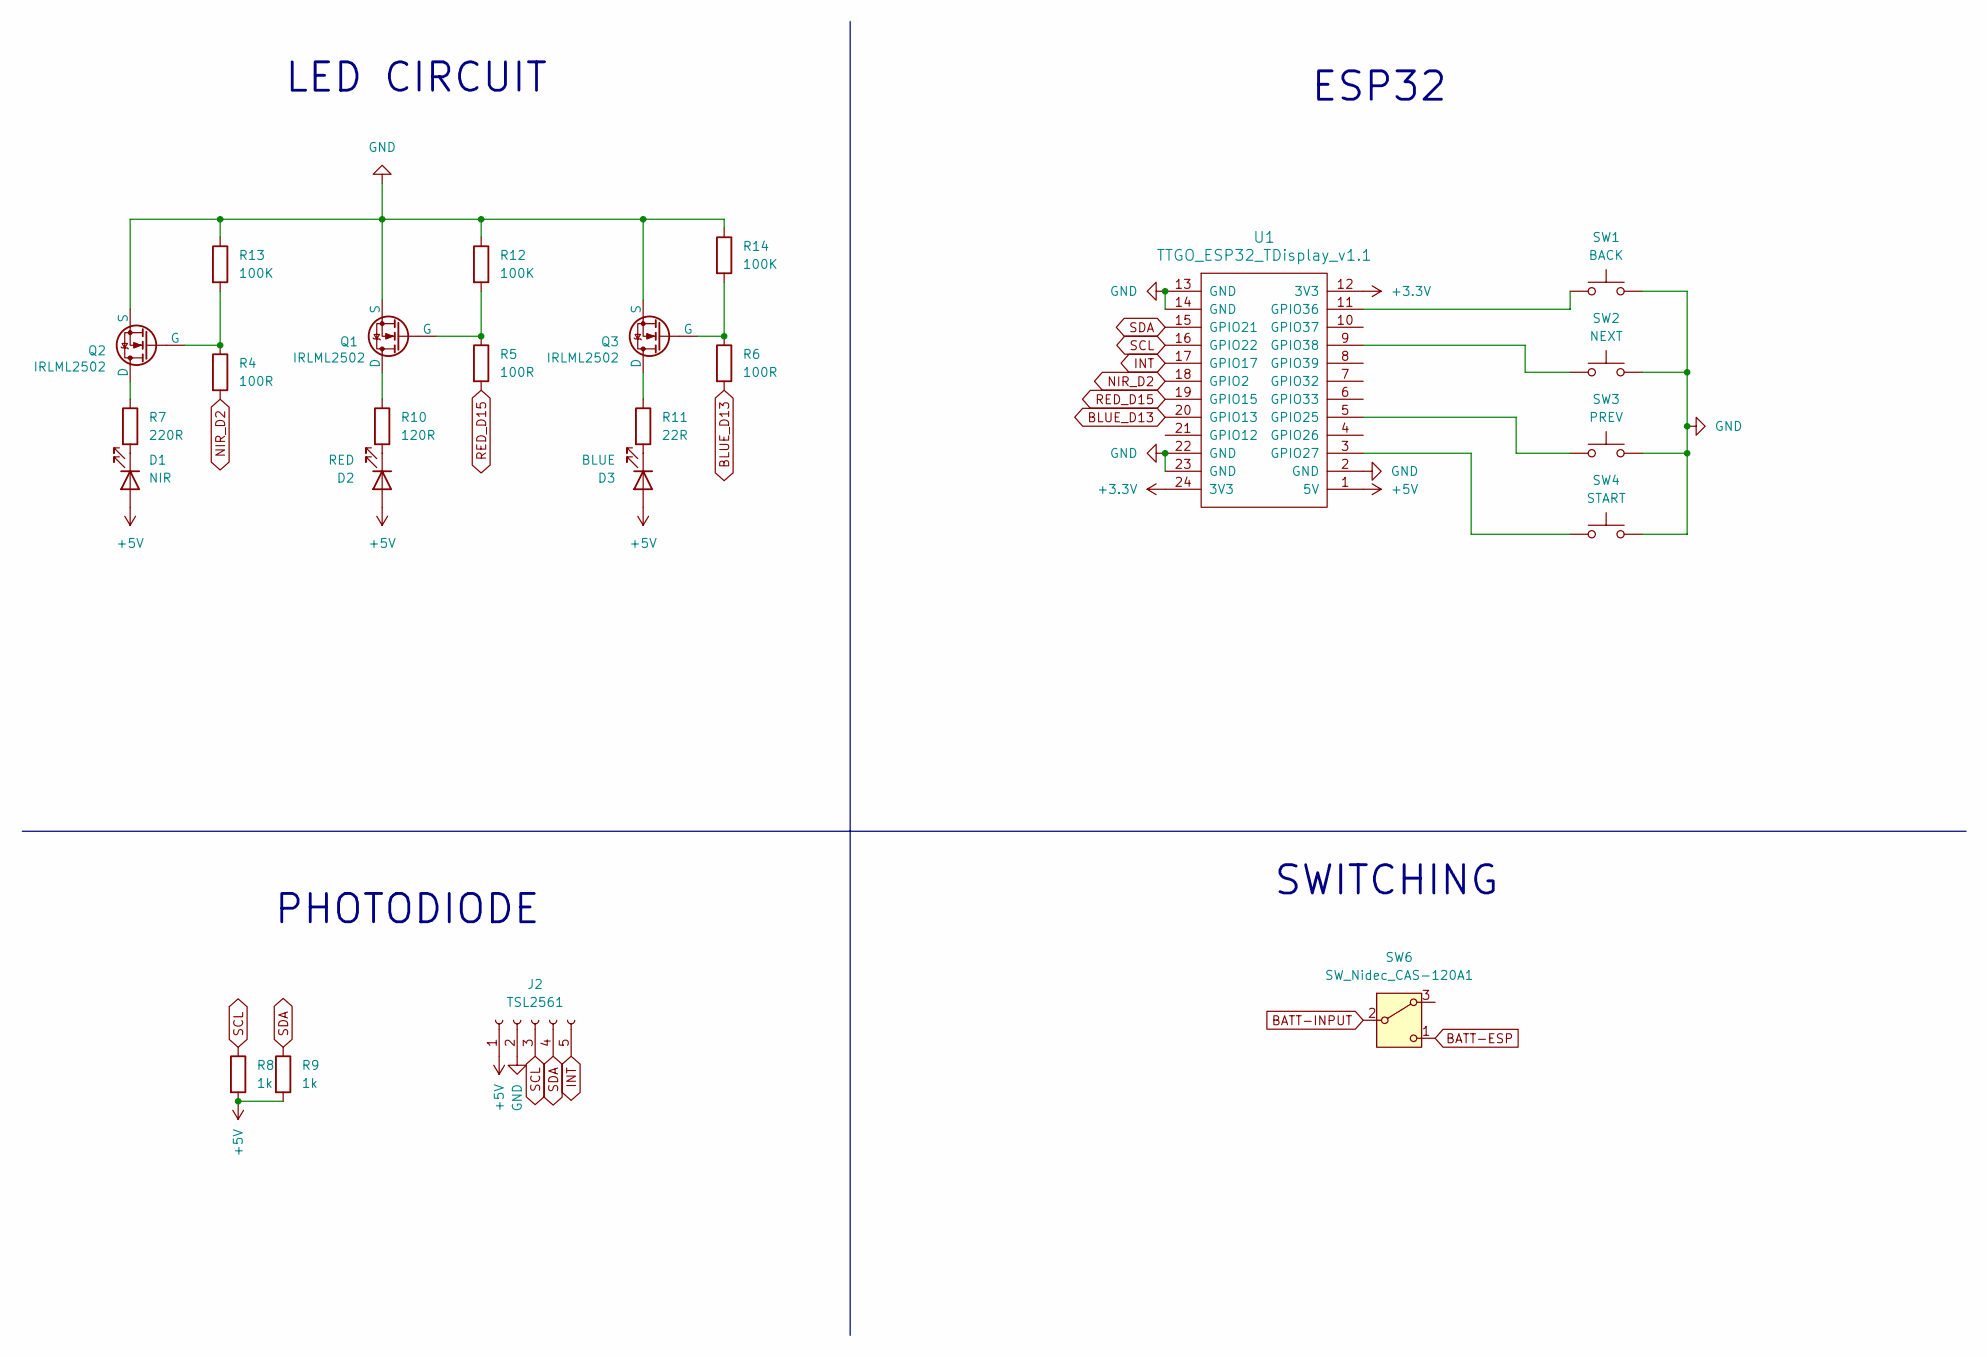
[picture p49: schematic Chloro_Gauage_V1.2.kicad_sch]

Parts:
D1: NIR; LED_0805_2012Metric_Pad1.15x1.40mm_HandSolder
D2: RED; LED_1206_3216Metric_Pad1.42x1.75mm_HandSolder
D3: BLUE; LED_1206_3216Metric_Pad1.42x1.75mm_HandSolder
J2: TSL2561; PinSocket_1x05_P2.54mm_Vertical
Q1, Q2, Q3: IRLML2502; TSOT-23
R4, R5, R6: 100R; R_1206_3216Metric_Pad1.30x1.75mm_HandSolder
R7: 220R; R_1206_3216Metric_Pad1.30x1.75mm_HandSolder
R8, R9: 1k; R_1206_3216Metric_Pad1.30x1.75mm_HandSolder
R10: 120R; R_1206_3216Metric_Pad1.30x1.75mm_HandSolder
R11: 22R; R_1206_3216Metric_Pad1.30x1.75mm_HandSolder
R12, R13, R14: 100K; R_1206_3216Metric_Pad1.30x1.75mm_HandSolder
SW1: BACK; SW_SPST_Omron_B3FS-105xP
SW2: NEXT; SW_SPST_Omron_B3FS-105xP
SW3: PREV; SW_SPST_Omron_B3FS-105xP
SW4: START; SW_SPST_Omron_B3FS-105xP
SW6: SW_Nidec_CAS-120A1; SW_DIP_SPSTx01_Slide_Copal_CVS-01xB_W5.9mm_P1mm
U1: TTGO_ESP32_TDisplay_v1.1

Connections:
+3.3V: U1.12 (3V3), U1.24 (3V3)
+5V: D1.2 (A), D2.2 (A), D3.2 (A), J2.1, R8.2, R9.2, U1.1 (5V)
BATT-ESP: SW6.1 (C)
BATT-INPUT: SW6.2 (B)
BLUE_D13: R6.2, U1.20 (GPIO13)
GND: J2.2, Q1.2 (S), Q2.2 (S), Q3.2 (S), R12.1, R13.1, R14.1, SW1.2, SW2.2, SW3.2, SW4.2, U1.2 (GND), U1.13 (GND), U1.14 (GND), U1.22 (GND), U1.23 (GND)
INT: J2.5, U1.17 (GPIO17)
NIR_D2: R4.2, U1.18 (GPIO2)
unnamed: D1.1 (K), R7.2
unnamed: D2.1 (K), R10.2
unnamed: D3.1 (K), R11.2
unnamed: Q1.3 (D), R10.1
unnamed: Q1.1 (G), R5.1, R12.2
unnamed: Q2.3 (D), R7.1
unnamed: Q2.1 (G), R4.1, R13.2
unnamed: Q3.3 (D), R11.1
unnamed: Q3.1 (G), R6.1, R14.2
unnamed: SW3.1, U1.5 (GPIO25)
unnamed: SW4.1, U1.3 (GPIO27)
unnamed: SW1.1, U1.11 (GPIO36)
unnamed: SW2.1, U1.9 (GPIO38)
RED_D15: R5.2, U1.19 (GPIO15)
SCL: J2.3, R8.1, U1.16 (GPIO22)
SDA: J2.4, R9.1, U1.15 (GPIO21)

Notes on the sheet:
SWITCHING
PHOTODIODE
LED CIRCUIT
ESP32

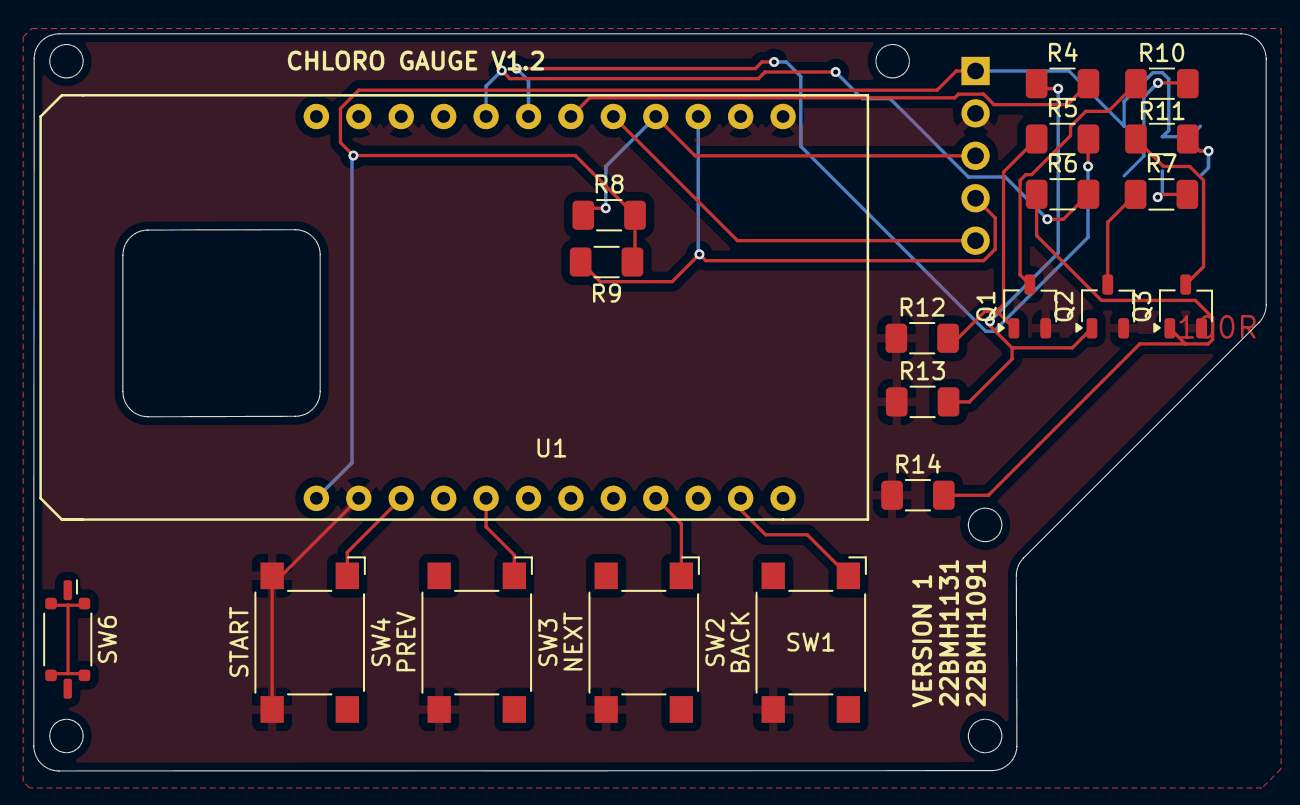
[picture p50: board Chloro_Gauage_V1.2.kicad_pcb from above]

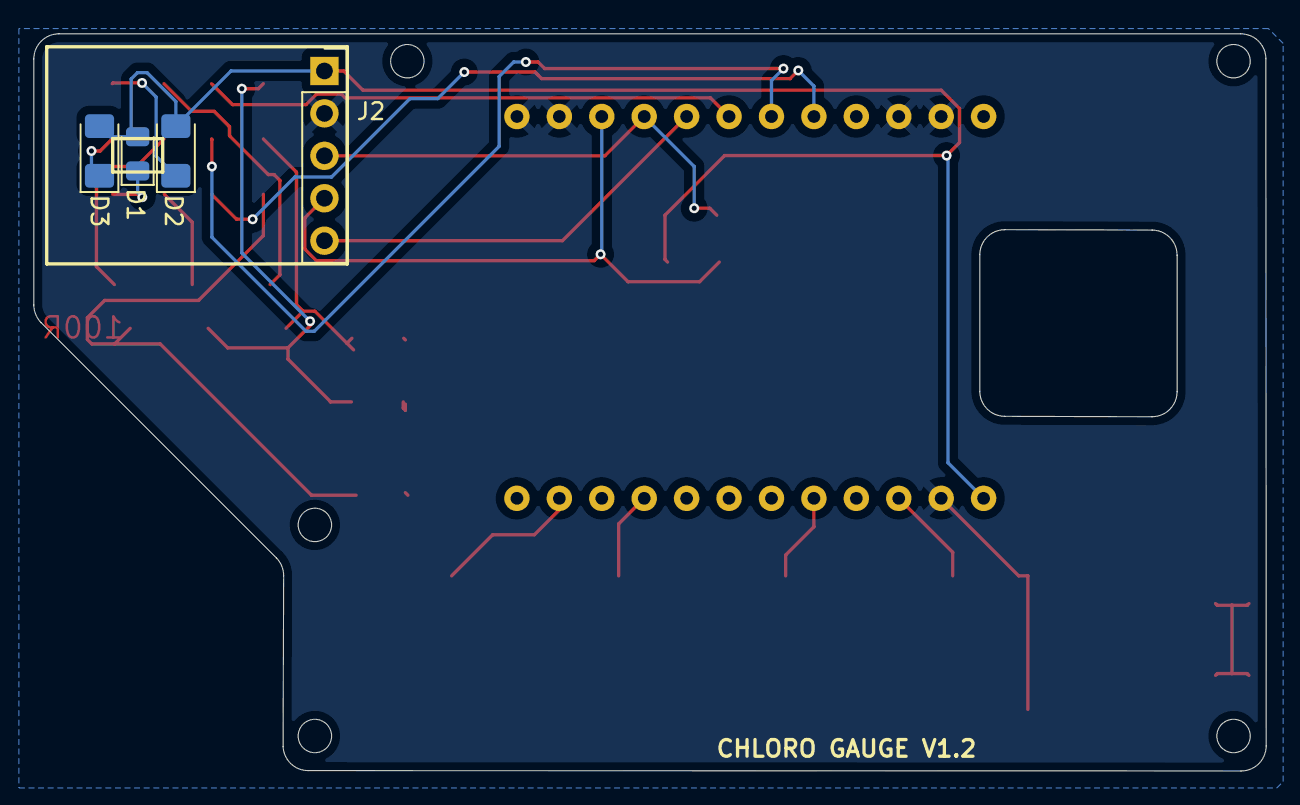
[picture p51: board Chloro_Gauage_V1.2.kicad_pcb from below]

Board: 2 copper layers, 73.8 x 44.1 mm, 24 parts (4 on the bottom side), 21 nets.
